rin67630/Victron_VE_on_Steroids/Software/Binaries/Readme.md

The .bin files in that directory are precompiled files intended to be directly uploaded to your ESP-Device using  
https://github.com/rin67630/ESP_Binary_patcher
Don't upload using another method, since the credentials are not patched and the software will not be able to connect.
