rin67630/Victron_VE_on_Steroids/Documentation/Karajan_Framework.md

Karajan is a framework and collaborative scheduler that I wrote years ago to facilite my developments on Arduino/ESP devices.  
I am an engineer, not a programmer.   
I hate it, when programms are written in Volapük, (my expression to describe code that has nothing left with natural language).  
Karajan is written for flexibility: it works intensively with computer directives to adapt the code to different 
situations.  
The Arduino IDE has a great feature: tabs.  
Karajan makes use of the Tabs features of the Arduino IDE to split the code like an orchestral partition into clear subparts  
for each instrument (purpose):  
-Configuration  
-Credentials (not to be published)  
-Libraries and global variables  
-Krarajan Network functions  
-User functions  
-Setup  
-Menu for user interaction.  
-Immediate Data (processed as fast as possible, only for asynchonous data from other devices)
-Fast data (to be processed at 125mS pace)  
-Slow data (to be processed at 1S pace)  
-Statistics (to be processed at 1S pace)  
-Display (to be processed at 1S pace)  
-Serial communiction (to be processed at 1S pace)  
-Wireless comminucation (to be processed at 1S pace)  
and finally the scheduler itself.  
With that organisation the developer can easily jump to the desired part of the code to make correction without searching pages of code for the right place.  
All jobs to be processed at 1S pace are distributed in 125mS slices, so to dispatch the processing time and avoid to do everything at the same time.  

Karajan provides a measuring/reporting function for the time taken by every task.  
It provides all initializations for WiFi and time synchronization, so you can just start with your part.  
It provides variables to do a lot of stuff at given times and gives global variables as e.g.  
Bytes:  
- Second, Minute, Hour...  
Boolean:  
- NewMinute, MinuteExpiring, NewHour, HourExpiring and so forth..  
so you can write code to be executed at given times in natural language.  

https://github.com/rin67630/ESP8266_Karajan
