rin67630/Victron_VE_on_Steroids/Hardware/Victron-on-Steroids-Smarter-Shunt_Schematic.png

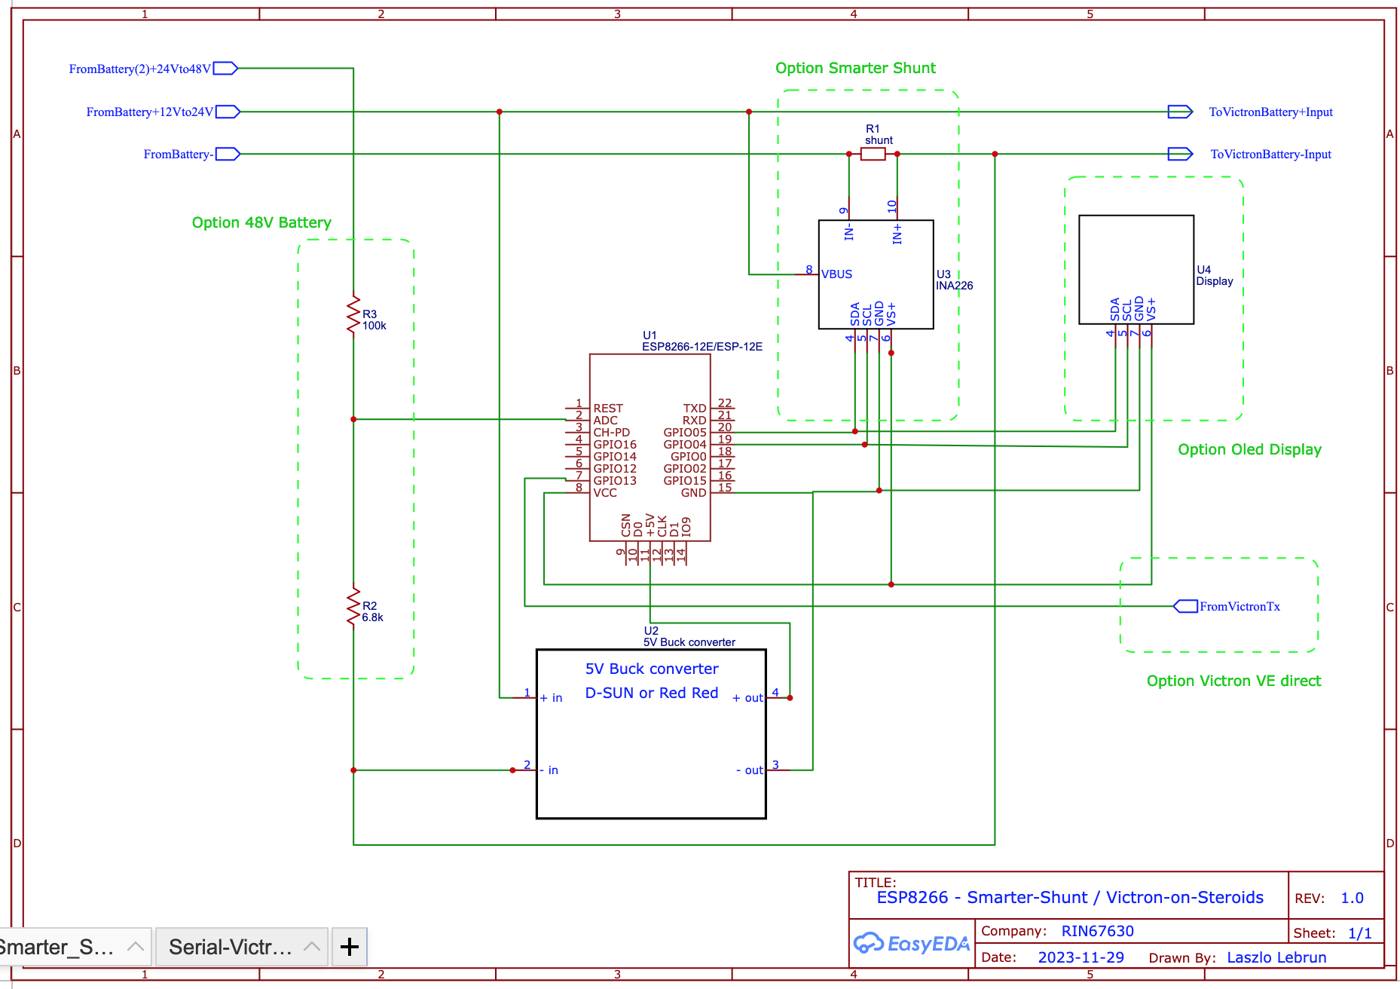
Hardware/Victron-on-Steroids-Smarter-Shunt_Schematic.png
