rin67630/Victron_VE_on_Steroids/(threads)

Thread 1 (2024-03-10):

FAQ: Screen of TTGO device does not show anything, compiler error TFT_BL not defined

rin67630, 2024-03-10:
You have defined CONTR_IS_TTGO and the compiler throws an error
TFT_BL not defined or/and your device's screen remains empty:

Check that you have copied the file Config_Files/User_Setup.h to the /libraries/TFT_eSPI/ folder.
The default file there is not suitable to work with a TTGO !

**This applies also after an update of the library TFT_eSPI !**

Closed 2024-03-10.

Thread 2 (2024-04-10):

bracket error

mgpoole, 2024-04-10:
https://github.com/rin67630/Victron_VE_on_Steroids/blob/main/Software/b2_User_Functions.ino fails to compile with an error.

Line 139 should be
    if (String(keywords[i]) == "CS")    payload.ChSt = atoi(value[i]) * 10;

rin67630, 2024-04-20:
Thank you for the correction !
You are right.
At my side it compiled without error, even after the misplaced bracket.

Closed 2024-04-22.

Thread 3 (2025-09-05):

Info: Bluetooth

mdmiko, 2025-09-05:
Hi,
can I use bluetooth connection on my smartsolar mppt's to use only one ESP? Thanks

rin67630, 2025-09-14:
Currently I did not program a Bluetooth connection, only a wired one.
But you don't need more than one ESP. The picture shows three variants for different usages...
Of course you need an ESP for each source of information, which is really not the problem, an ESP costs peanuts.
