rin67630/Victron_VE_on_Steroids/Software/h_Serial.ino

void serialRun() {
  switch (serialPage) {
    case 'A':  // Print A0
      //char timeStr[30];
      offsettedNow = now - 86400;
      offsettedTimeinfo = localtime(&offsettedNow);
      strftime(charbuff, 30, "%x ", offsettedTimeinfo);
      Console1.println();
      Console1.print(charbuff);
      Console1.print(" A0: ");
      Console1.println(analogRead(A0));
      serialPage = 0;
      break;

    case 'B':  //Battery Report
      Console1.print(" Hour   |");
      for (byte n = 0; n < 12; n++) {
        Console1.printf("  %02u   |", n);
      }
      Console1.print("\n Bat Ah |");
      for (byte n = 0; n < 12; n++) {
        Console1.printf(" %05.2f |", BatAh[n]);
      }
      Console1.print("\n Bat V  |");
      for (byte n = 0; n < 12; n++) {
        Console1.printf(" %05.2f |", BatVavg[n]);
      }
      Console1.print("\n Hour   |");
      for (byte n = 12; n < 24; n++) {
        Console1.printf("  %02u   |", n);
      }
      Console1.print("\n Bat Ah |");
      for (byte n = 12; n < 24; n++) {
        Console1.printf(" %05.2f |", BatAh[n]);
      }
      Console1.print("\n Bat V  |");
      for (byte n = 12; n < 24; n++) {
        Console1.printf(" %05.2f |", BatVavg[n]);
      }
      Console1.println("");
      serialPage = 0;
      break;

    case 'D':                               //Debug report
      Console1.printf("A0: %i BatV:%05.2fV BatI:%05.3fA CellV: %5.3fV BatPoC:%4.1f%% IOhm:%5.4fR State: ", analogRead(A0), payload.BatV, payload.BatI, CellV, BatPoC, payload.IOhm);
      Console1.println(StateKeywords[payload.ChSt]);
      break;

    case 'J':  // Job Duration Report for debuggging
      Console1.printf("\nJob Durations(mS) Current - Max\nSche:%03i - %03i \nFast:%03i - %03i\nSlow:%03i - %03i\nStat:%03i - %03i\nDisp:%03i - %03i\nSeri:%03i - %03i\nWifi:%03i - %03i\n",
                      RunMillis[1] - RunMillis[0], RunMillis[14], RunMillis[3] - RunMillis[2], RunMillis[15], RunMillis[5] - RunMillis[4], RunMillis[16], RunMillis[7] - RunMillis[6], RunMillis[17],
                      RunMillis[9] - RunMillis[8], RunMillis[18], RunMillis[11] - RunMillis[10], RunMillis[19], RunMillis[13] - RunMillis[12], RunMillis[20]);
      // serialPage = 0; // disabled One shot reset serial page.
      break;

    case 'V':  //Print Values
      Console1.printf("BatV:%05.2f BatI:%05.2f BatW: %05.2f PanV: %05.2f PanI: %05.2f PanW: %05.2f LoadI: %05.2f LoadW: %05.2f BatR: %5.4f POC:%4.1f\n", payload.BatV, payload.BatI, payload.BatW, payload.PanV, payload.PanI, payload.PanW, payload.LodI, payload.LodW, payload.IOhm, BatPoC);
      break;

    case 'W':  // Weather Plot
      Console1.printf("Temp: %2.1f°C Hum: %2.1f%% Press: %4.0fmBAR WindSpeed: %2.1fm/s Direction: %u°N Clouds: %u%% Summary: ", temperature, humidity, pressure, wind_speed, wind_direction, cloudiness);
      Console1.println(weather_summary);
      serialPage = ' ';
      break;

  }  // end Switch Serial page
}
