rin67630/Victron_VE_on_Steroids/(commit log)

2023-12-02 Add files via upload
    Finished internal resistance computation
2023-12-06 Add files via upload
    Schematic including options like
    - Smart-Shunt measurement
    - Oled Display
    - 2nd battery / PV panel voltage measurement
2024-02-02 Adding 48V option
    #define INA_VBUS_IS_HALF // _FULL _HALF (when high voltage schematic is used)
2024-03-13 General cleanup, streamline code, multi ESP, Displa support
    Now runs and tested on ESP8266, ESP 32 (with or without OLED), Wemos32OLED, TTGO T1 with colour display.
    Separate ESP32 software folder removed, now the code is universal.
2024-03-13 BME680 Climate sensor added
2024-03-14 Update README.md
    Adding remote screens on an ESP32 TTGO.
2024-03-17 Update a_Libs_Vars.ino
    Regression corrected on
    //*** Buffers ***
    static char charbuff[120]; //Char buffer for many functions
    unsigned char UDPCharPayload[sizeof(payload)]; // Array of characters as image of the structure for UDP xmit/rcv
    String JSONpayload;
    [a_Libs_Vars.ino]
2024-03-18 Update g_Display.ino
    Corrected bug display PoC
    [g_Display.ino]
2024-03-24 Harmonized schematics.
2024-04-25 Update d_Menu.ino
    Added 'X' command to erase WiFi data and reset device.
    [d_Menu.ino]
2024-10-01 Added Raspberry Pi_Solar:UPS.bin file
2024-10-05 Create RaspberryPi_Solar_UPS_Dashb.h
    Dashboard configuration to be pasted into thinger.io
